newaetech/cw310-bergen-board/microfw/CW310/README.md

This folder contains the C firmware for the SAM3X on the CW310 board.

The Makefile for building is in the `Debug` folder.

The `atmel_devices_cdc.inf` driver shouldn't be required anymore
with the updated USB support.

See `README.md` instructions one folder down for build instructions.
