newaetech/cw310-bergen-board/docs/Images/CW310block.png

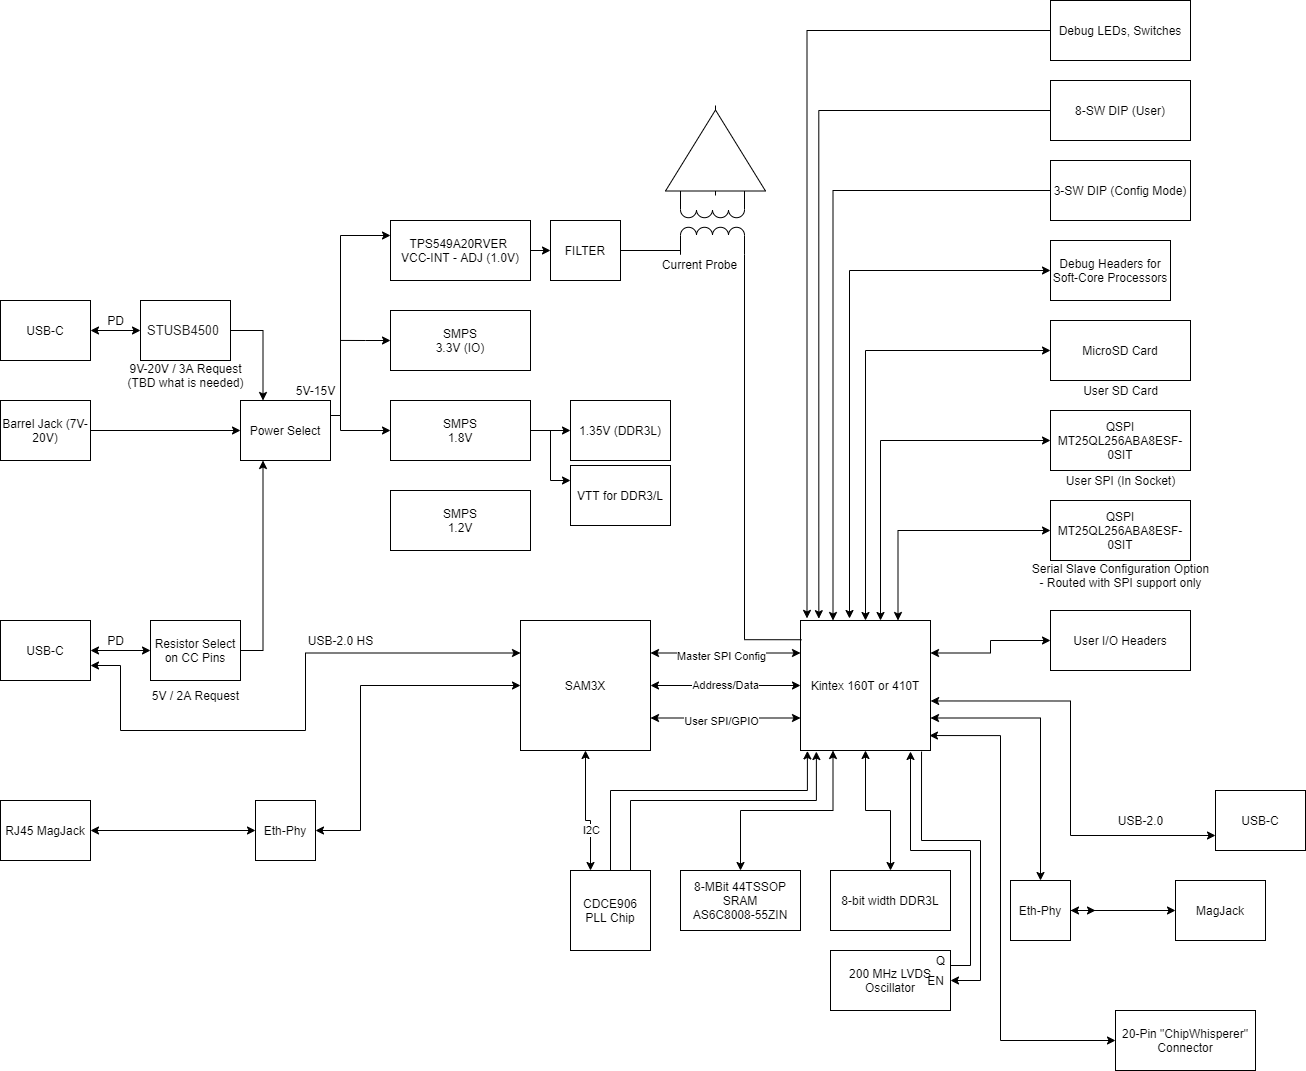
docs/Images/CW310block.png
