newaetech/cw310-bergen-board/docs/Images/switch_controlpower.jpeg

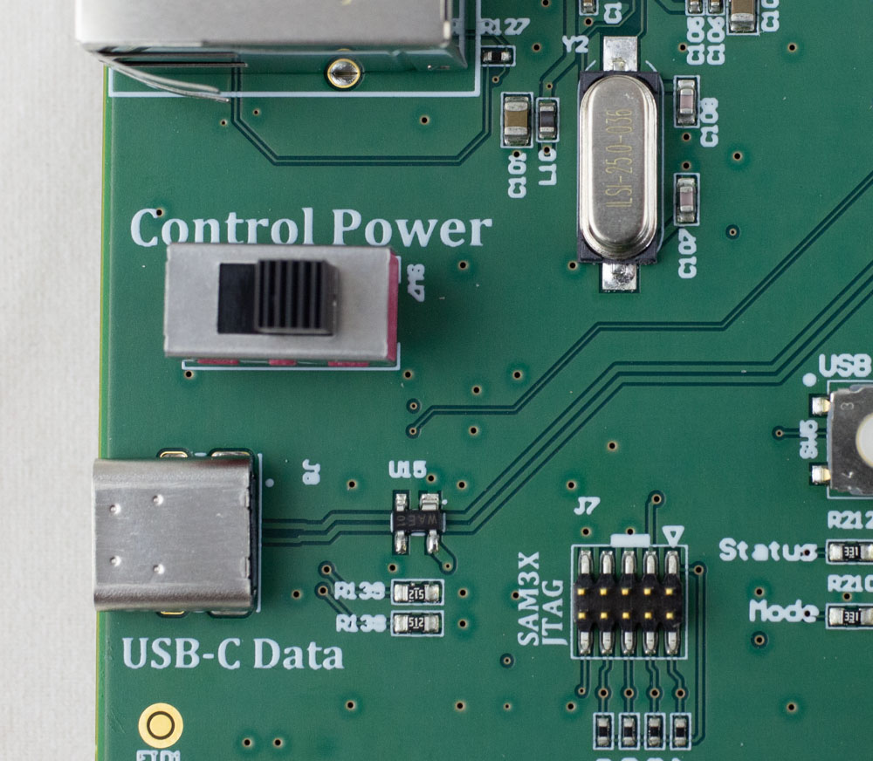
docs/Images/switch_controlpower.jpeg
