newaetech/cw310-bergen-board/docs/Images/cw310-userdebug.jpeg

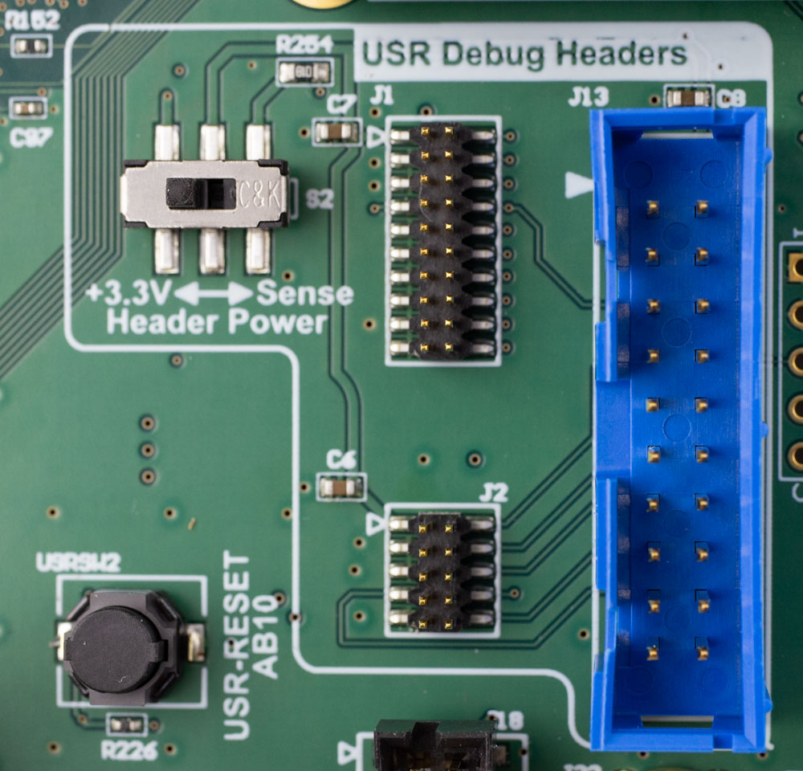
docs/Images/cw310-userdebug.jpeg
