newaetech/cw310-bergen-board/(threads)

Thread 3 (2021-06-08):

PLL / i2c hang-up

colinoflynn, 2021-06-08:
Issues report w/ the PLL set - not sure if just by chance or that is the real culprit. Based on their description (one write works, 2nd fails) I suspect the I2C code is locking up & blocks the USB processing from then on.

See https://github.com/lowRISC/opentitan/issues/6878

Should setup a stress test to slam PLL config messages. Is the PLL config message colliding with a random I2C read/write from temp?

colinoflynn, 2021-06-08:
Confirmed it happens with:

```
import chipwhisperer as cw
from chipwhisperer.capture.targets.CW310 import CW310

import time

def main():

    target = cw.target(None, CW310, bsfile=None, slurp=False)

    print("CW310 Board Found:")

    int i = 0
    while(True):
        print("Round %d"%i)
        target.pll.pll_enable_set(True)
        target.pll.pll_outenable_set(False, 0)
        # Note: 1 and 2 seem to be reversed.
        target.pll.pll_outenable_set(True, 1)
        target.pll.pll_outenable_set(False, 2)

        # Note: both 1 and 2 need to be set, even if only 1 is enabled.
        target.pll.pll_outfreq_set(100E6, 1)
        target.pll.pll_outfreq_set(100E6, 2)

        i += 1

        time.sleep(0.5)

    print("Loading done.")

if __name__ == "__main__":
    main()

```

colinoflynn, 2021-06-11:
Fixed by Alex - currently requires 'husky' branch of chipwhisperer, will close this one done in main develop branch.

Closed 2021-09-08.

Thread 4 (2021-06-08):

Update PCB to fix LNA Issues

colinoflynn, 2021-06-08:
Currently work-around on LNA required which is done with a PCB mod. Need to fix PCB:

* Improve grounding around LNA part.
* Change routing to remove longer path.

Thread 6 (2021-11-11):

Board files for vivado

nicolast0604, 2021-11-11:
If I would like to work on this board with Vivado, shall I install the board files?
If yes, where can I get it?

colinoflynn, 2021-11-11:
You can find two example applications at https://github.com/newaetech/cw310-bergen-board/tree/main/fpga - the "aes" examples is like the CW305 one, the "test" is a board test we use in production.

There is an XCF file at https://github.com/newaetech/cw310-bergen-board/tree/main/pins as well for your use.

If you want to run OpenTitan on the board you can follow the getting started guide one opentitan.org.

nicolast0604, 2021-11-11:
Hi Colinoflynn
I just followed the steps in opentitan and it is successful in implementation but failed in bitstream generation.
I opened the hardware manager and it seems connected but no target information showed.

As the experience of nexys video, I downloaded the board files from digilent and put it in the /data of the install path of Vivado.
I am wondering if I need to do the same thing to make the bitstream successfully?

Best Regards

nicolast0604, 2021-11-18:
Hi
My question is that I would like to let Vivado's hardware manager can recognize the CW310 board and let me program the device.
However, so far it shows no hardware target is open and only have localhost(0) status connected.

This is very confusing.

colinoflynn, 2021-11-18:
Got it! I misunderstood the problem there.

Do you have an external JTAG cable? The CW310 doesn't appear under Vivado, you need an external JTAG cable for this (Xilinx Platform USB cable or Xilinx SmartLynq cable). [Minor technical note - Xilinx doesn't provide a documented way of allowing us to do this is the main reason why, there is some special deal with Digilent allowing usage but it's never been clear on the license even if we reverse engineered it. As a result the FPGA jtag lines are just routed to a header on the board.]

nicolast0604, 2021-11-19:
Step 6 from the opentitan guideline,
Use a USB-C cable to connect your PC with the USB-C Data connector (J8) in the lower left corner on the board.

do you mean that we need to use Xilinx Platform USB cable or Xilinx SmartLynq cable to replace this?

Is this just make this FPGA board visable to Vivado or
it needs to even transfer the bit stream or firmware to the board?

Thread 7 (2023-06-26):

How to load firmware for SAM3X?

houdonghui1, 2023-06-26:
Hello engineers!!
How can I load the firmware on the CW310 board onto the SAM3X on my board? Under what operating system can software be used to load firmware onto the MCU? Is there a method explanation?

colinoflynn, 2023-06-26:
Hello,

The SAM3X firmware uses the same firmware loading as ChipWhisperer, so it works in Python (Windows or Linux). The FW update mechanism is described at https://chipwhisperer.readthedocs.io/en/latest/scope-api.html#firmware-update .

If the SAM3X is blank, use:

```
import chipwhisperer as cw
programmer = cw.SAMFWLoader(scope=None)
programmer.program(<port>, 'CW310.bin')
```
Where <port> is COMx, /dev/ttyUSB, etc depending on platform. You can also force erase the SAM3X with the 'erase' pins (jumper with wire/paperclip). But you can use the ChipWhisperer API to enter bootloader mode automatically too.

CW310 is built from running `make` here: https://github.com/newaetech/cw310-bergen-board/tree/main/microfw/CW310/src

ViennaPan, 2024-01-04:
Hi Colinoflynn,
When I trying to do SAM3X with:
programmer = cw.SAMFWLoader(scope=target)
programmer.enter_bootloader(really_enter=True)

I see all the power are down in CW310 board, and cannot get the target for ever.
Do you know why this occurring?
Before this erasing, I can use the USB-C Data to get the target and do fpga_read and fpga_write already. Now all are not working as all power off.
Thanks,
Vienna

colinoflynn, 2024-01-04:
Hello,

This will just erase the SAM3X, does it come back up as a serial port? Are you on Windows or Linux? If on Linux you can check `dmesg` to see if the SAM3X comes up as a serial port. If you press the "USB RST" button, it will reenumeate the SAM3X which might make it more obvious (or unplug/replug USB cable):

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

The command from there is:

```
import chipwhisperer as cw
programmer = cw.SAMFWLoader(scope=None)
programmer.program(<port>, 'CW310.bin')
```

Where CW310.bin is available [here](https://github.com/newaetech/cw310-bergen-board/blob/main/microfw/CW310/src/CW310.bin). Just download to your local file.

If the serial port isn't coming up, it could be the erase failed. There is an "erase" jumper (pins) on the PCB, you can short with a paperclip/wire which should also force the erase.

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

ViennaPan, 2024-01-05:
Hi colinoflynn,
Your method works. As the target cannot be get, I have to use the scope=None instead of scope=target in cw.SAMFWLoader. And the program is working.
Thanks,
Vienna

ViennaPan, 2024-01-08:
Hi colinoflynn,
The bin file "CW310 is built from running make here: https://github.com/newaetech/cw310-bergen-board/tree/main/microfw/CW310/src" has a problem that the byte counter of the bit 0 and bit 1 are by default as 1,  which is not working for plaintext and key write (any other 16 bytes write will be failed:
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
I added a workaround to not use the lowest 2 bits and find out that it is not supporting bit index 5 and index 6.
Could you help to check why?
Thanks,
Vienna

Thread 9 (2024-03-25):

CDCE906 Read Error

alex-dewar, 2024-03-25:
Latest firmware (1.3.0) seems to have broken I2C:

```python
>>> target = cw.target(None, cw.targets.CW310)
Traceback (most recent call last):
  File "<stdin>", line 1, in <module>
  File "/home/jw/projects/chipwhisperer/software/chipwhisperer/__init__.py", line 422, in target
    rtn.con(scope, **kwargs)
  File "/home/jw/projects/chipwhisperer/software/chipwhisperer/capture/targets/_base.py", line 65, in con
    self._con(scope, **kwargs)
  File "/home/jw/projects/chipwhisperer/software/chipwhisperer/capture/targets/CW310.py", line 143, in _con
    self.pll.cdce906init()
  File "/home/jw/projects/chipwhisperer/software/chipwhisperer/hardware/naeusb/pll_cdce906.py", line 265, in cdce906init
    self.outputUpdateOutputs(0)
  File "/home/jw/projects/chipwhisperer/software/chipwhisperer/hardware/naeusb/pll_cdce906.py", line 94, in outputUpdateOutputs
    pll_enabled = self.pll_outenable_get(outnum)
  File "/home/jw/projects/chipwhisperer/software/chipwhisperer/hardware/naeusb/pll_cdce906.py", line 140, in pll_outenable_get
    data = self.cdce906read(19 + outpin)
  File "/home/jw/projects/chipwhisperer/software/chipwhisperer/hardware/naeusb/pll_cdce906.py", line 255, in cdce906read
    raise IOError("CDCE906 Read Error, response = %d" % resp[0])
OSError: CDCE906 Read Error, response = 3
```

This works on earlier versions (1.2.0). Presumably something was changed when adding CW340 support that broke I2C.

alex-dewar, 2024-03-26:
Hopefully fixed by 76231fd01b90df4d3991aaca317a41fce6d278d3

Closed 2024-04-15.

Thread 10 (2024-10-16):

PLL numbers swapped for Bergen Board

KyleM32767, 2024-10-16:
On the CW310 Bergen Board, the numbers of the PLL outputs when calling `target.pll` methods do not correspond to the correct PLL output numbers. (i.e. calling `target.pll.pll_outenable_set(True, 2)` enables PLL output 1, and vice versa).

Looking at the schematic and constraint file, it seems like this is because the signals for PLL_CLK1 and PLL_CLK2 are on pins Y4 and Y1, respectively of the external PLL.

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

```
#####
# Input Clocks
#####

set_property -dict { PACKAGE_PIN  R22  IOSTANDARD   LVCMOS33 } [get_ports { PLL_CLK1 }]; #IO_L14P_T2_SRCC_13
set_property -dict { PACKAGE_PIN  N21  IOSTANDARD   LVCMOS33 } [get_ports { PLL_CLK2 }]; #IO_L12P_T1_MRCC_13
```

However [the API](https://github.com/newaetech/chipwhisperer/blob/develop/software/chipwhisperer/hardware/naeusb/pll_cdce906.py) assumes PLL_CLK1 is on pin Y1 and PLL_CLK2 is on Y4...

```py
    def outputUpdateOutputs(self, outnum, pllsrc_new=None, pllenabled_new=None, pllslewrate_new=None):
        """Update the output pins with enabled/disabled, slew rate, etc"""
        outnum = self.swap_340_pllnum(outnum)
        # Map to output pins on CDCE906 Chip
        if outnum == 0:
            outpin = 0
            if pllsrc_new is None:
                src = self._pll0source
            else:
                src = pllsrc_new

            if src == 'PLL0':
                divsrc = 0
            elif src == 'PLL1':
                divsrc = 1
            elif src == 'PLL2':
                divsrc = 2
        elif outnum == 1:
            outpin = 1
            divsrc = 1
        elif outnum == 2:
            outpin = 4
            divsrc = 2
```

The CW305 is that way, which tells me this is just a mistake with the CW310 design.

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

**TLDR: Switch the labels for PLL_CLK1 and PLL_CLK2 on the schematic and `bergen.xdc`**
