newaetech/cw310-bergen-board/fpga/aes/cw310.xdc

# default unless otherwise specified:
set_property IOSTANDARD LVCMOS33 [get_ports *]

set_property -dict { PACKAGE_PIN C16   IOSTANDARD LVCMOS33 } [get_ports { vauxp0 }]
set_property -dict { PACKAGE_PIN B16   IOSTANDARD LVCMOS33 } [get_ports { vauxn0 }]
set_property -dict { PACKAGE_PIN B17   IOSTANDARD LVCMOS33 } [get_ports { vauxp1 }]
set_property -dict { PACKAGE_PIN A19   IOSTANDARD LVCMOS33 } [get_ports { vauxn1 }]
set_property -dict { PACKAGE_PIN A18   IOSTANDARD LVCMOS33 } [get_ports { vauxp8 }]
set_property -dict { PACKAGE_PIN B16   IOSTANDARD LVCMOS33 } [get_ports { vauxn8 }]

set_property -dict { PACKAGE_PIN Y23   IOSTANDARD LVCMOS33 } [get_ports { usb_clk }]
set_property -dict { PACKAGE_PIN A23   IOSTANDARD LVCMOS33 } [get_ports { usb_trigger }]

#set_property -dict { PACKAGE_PIN  Y25  IOSTANDARD   LVCMOS33 } [get_ports { USB_nALE }]; #IO_L10P_T1_12
set_property -dict { PACKAGE_PIN AA23  IOSTANDARD   LVCMOS33 } [get_ports { USB_nCE }]; #IO_L11P_T1_SRCC_12
set_property -dict { PACKAGE_PIN AC23  IOSTANDARD   LVCMOS33 } [get_ports { USB_nRD }]; #IO_L14P_T2_SRCC_12
set_property -dict { PACKAGE_PIN AA25  IOSTANDARD   LVCMOS33 } [get_ports { USB_nWR }]; #IO_L7P_T1_12
set_property -dict { PACKAGE_PIN AC26  IOSTANDARD   LVCMOS33 } [get_ports { USB_A[0]  }]; #IO_L9N_T1_DQS_12
set_property -dict { PACKAGE_PIN AD26  IOSTANDARD   LVCMOS33 } [get_ports { USB_A[1]  }]; #IO_L21P_T3_DQS_12
set_property -dict { PACKAGE_PIN AD25  IOSTANDARD   LVCMOS33 } [get_ports { USB_A[2]  }]; #IO_L23P_T3_12
set_property -dict { PACKAGE_PIN AE26  IOSTANDARD   LVCMOS33 } [get_ports { USB_A[3]  }]; #IO_L21N_T3_DQS_12
set_property -dict { PACKAGE_PIN AB24  IOSTANDARD   LVCMOS33 } [get_ports { USB_A[4]  }]; #IO_L11N_T1_SRCC_12
set_property -dict { PACKAGE_PIN AC24  IOSTANDARD   LVCMOS33 } [get_ports { USB_A[5]  }]; #IO_L14N_T2_SRCC_12
set_property -dict { PACKAGE_PIN AD24  IOSTANDARD   LVCMOS33 } [get_ports { USB_A[6]  }]; #IO_L16N_T2_12
set_property -dict { PACKAGE_PIN AD23  IOSTANDARD   LVCMOS33 } [get_ports { USB_A[7]  }]; #IO_L16P_T2_12
set_property -dict { PACKAGE_PIN AB26  IOSTANDARD   LVCMOS33 } [get_ports { USB_A[8]  }]; #IO_L9P_T1_DQS_12
set_property -dict { PACKAGE_PIN AB25  IOSTANDARD   LVCMOS33 } [get_ports { USB_A[9]  }]; #IO_L7N_T1_12
set_property -dict { PACKAGE_PIN  W23  IOSTANDARD   LVCMOS33 } [get_ports { USB_A[10] }]; #IO_L8P_T1_12
set_property -dict { PACKAGE_PIN  V23  IOSTANDARD   LVCMOS33 } [get_ports { USB_A[11] }]; #IO_L3P_T0_DQS_12
set_property -dict { PACKAGE_PIN  Y21  IOSTANDARD   LVCMOS33 } [get_ports { USB_A[12] }]; #IO_L15N_T2_DQS_12
set_property -dict { PACKAGE_PIN  U24  IOSTANDARD   LVCMOS33 } [get_ports { USB_A[13] }]; #IO_L2P_T0_12
set_property -dict { PACKAGE_PIN  U22  IOSTANDARD   LVCMOS33 } [get_ports { USB_A[14] }]; #IO_L1P_T0_12
set_property -dict { PACKAGE_PIN  V22  IOSTANDARD   LVCMOS33 } [get_ports { USB_A[15] }]; #IO_L1N_T0_12
set_property -dict { PACKAGE_PIN  U21  IOSTANDARD   LVCMOS33 } [get_ports { USB_A[16] }]; #IO_0_12
set_property -dict { PACKAGE_PIN  V21  IOSTANDARD   LVCMOS33 } [get_ports { USB_A[17] }]; #IO_L6P_T0_12
set_property -dict { PACKAGE_PIN  W21  IOSTANDARD   LVCMOS33 } [get_ports { USB_A[18] }]; #IO_L6N_T0_VREF_12
set_property -dict { PACKAGE_PIN  W20  IOSTANDARD   LVCMOS33 } [get_ports { USB_A[19] }]; #IO_L15P_T2_DQS_12
set_property -dict { PACKAGE_PIN  U25  IOSTANDARD   LVCMOS33 } [get_ports { USB_D[0] }]; #IO_L2N_T0_12
set_property -dict { PACKAGE_PIN  U26  IOSTANDARD   LVCMOS33 } [get_ports { USB_D[1] }]; #IO_L4P_T0_12
set_property -dict { PACKAGE_PIN AC21  IOSTANDARD   LVCMOS33 } [get_ports { USB_D[2] }]; #IO_L18N_T2_12
set_property -dict { PACKAGE_PIN  V24  IOSTANDARD   LVCMOS33 } [get_ports { USB_D[3] }]; #IO_L3N_T0_DQS_12
set_property -dict { PACKAGE_PIN  V26  IOSTANDARD   LVCMOS33 } [get_ports { USB_D[4] }]; #IO_L4N_T0_12
set_property -dict { PACKAGE_PIN  W26  IOSTANDARD   LVCMOS33 } [get_ports { USB_D[5] }]; #IO_L5N_T0_12
set_property -dict { PACKAGE_PIN  W25  IOSTANDARD   LVCMOS33 } [get_ports { USB_D[6] }]; #IO_L5P_T0_12
set_property -dict { PACKAGE_PIN  Y26  IOSTANDARD   LVCMOS33 } [get_ports { USB_D[7] }]; #IO_L10N_T1_12


set_property -dict { PACKAGE_PIN  M26  IOSTANDARD   LVCMOS33 } [get_ports { USRLED0 }]; #IO_L5N_T0_13
set_property -dict { PACKAGE_PIN  M25  IOSTANDARD   LVCMOS33 } [get_ports { USRLED1 }]; #IO_L3P_T0_DQS_13
set_property -dict { PACKAGE_PIN  M24  IOSTANDARD   LVCMOS33 } [get_ports { USRLED2 }]; #IO_L8P_T1_13
#set_property -dict { PACKAGE_PIN  M19  IOSTANDARD   LVCMOS33 } [get_ports { USRLED3 }]; #IO_L22N_T3_13
#set_property -dict { PACKAGE_PIN  L25  IOSTANDARD   LVCMOS33 } [get_ports { USRLED4 }]; #IO_L3N_T0_DQS_13
#set_property -dict { PACKAGE_PIN  K26  IOSTANDARD   LVCMOS33 } [get_ports { USRLED5 }]; #IO_L1N_T0_13
#set_property -dict { PACKAGE_PIN  L24  IOSTANDARD   LVCMOS33 } [get_ports { USRLED6 }]; #IO_L8N_T1_13
#set_property -dict { PACKAGE_PIN  K25  IOSTANDARD   LVCMOS33 } [get_ports { USRLED7 }]; #IO_L1P_T0_13


set_property -dict { PACKAGE_PIN   U9  IOSTANDARD   LVCMOS18 } [get_ports { USRDIP0 }]; #IO_0_VRN_33
set_property -dict { PACKAGE_PIN   V7  IOSTANDARD   LVCMOS18 } [get_ports { USRDIP1 }]; #IO_L2N_T0_33
#set_property -dict { PACKAGE_PIN   V8  IOSTANDARD   LVCMOS18 } [get_ports { USRDIP2 }]; #IO_L2P_T0_33
#set_property -dict { PACKAGE_PIN   W9  IOSTANDARD   LVCMOS18 } [get_ports { USRDIP3 }]; #IO_L3N_T0_DQS_33
#set_property -dict { PACKAGE_PIN   V9  IOSTANDARD   LVCMOS18 } [get_ports { USRDIP4 }]; #IO_L6P_T0_33
#set_property -dict { PACKAGE_PIN   W8  IOSTANDARD   LVCMOS18 } [get_ports { USRDIP5 }]; #IO_L6N_T0_VREF_33
#set_property -dict { PACKAGE_PIN  W10  IOSTANDARD   LVCMOS18 } [get_ports { USRDIP6 }]; #IO_L3P_T0_DQS_33
#set_property -dict { PACKAGE_PIN  V11  IOSTANDARD   LVCMOS18 } [get_ports { USRDIP7 }]; #IO_L1P_T0_33


#set_property -dict { PACKAGE_PIN  Y11  IOSTANDARD   LVCMOS18 } [get_ports { USRSW0 }]; #IO_L5P_T0_33
#set_property -dict { PACKAGE_PIN  Y10  IOSTANDARD   LVCMOS18 } [get_ports { USRSW1 }]; #IO_L5N_T0_33
set_property -dict { PACKAGE_PIN   Y7  IOSTANDARD   LVCMOS18 } [get_ports { USRSW2 }]; #IO_L4N_T0_33


set_property -dict { PACKAGE_PIN AB21  IOSTANDARD   LVCMOS33 } [get_ports { CWIO_HS1 }]; #IO_L18P_T2_12
set_property -dict { PACKAGE_PIN  Y22  IOSTANDARD   LVCMOS33 } [get_ports { CWIO_HS2 }]; #IO_L13P_T2_MRCC_12
#set_property -dict { PACKAGE_PIN AE25  IOSTANDARD   LVCMOS33 } [get_ports { CWIO_IO1 }]; #IO_L23N_T3_12
#set_property -dict { PACKAGE_PIN AF25  IOSTANDARD   LVCMOS33 } [get_ports { CWIO_IO2 }]; #IO_L20N_T3_12
#set_property -dict { PACKAGE_PIN AF23  IOSTANDARD   LVCMOS33 } [get_ports { CWIO_IO3 }]; #IO_L22N_T3_12
set_property -dict { PACKAGE_PIN AF24  IOSTANDARD   LVCMOS33 } [get_ports { CWIO_IO4 }]; #IO_L20P_T3_12
#set_property -dict { PACKAGE_PIN AE21  IOSTANDARD   LVCMOS33 } [get_ports { CWIO_MISO }]; #IO_L19N_T3_VREF_12
#set_property -dict { PACKAGE_PIN AF22  IOSTANDARD   LVCMOS33 } [get_ports { CWIO_MOSI }]; #IO_L24N_T3_12
#set_property -dict { PACKAGE_PIN  Y20  IOSTANDARD   LVCMOS33 } [get_ports { CWIO_RST }]; #IO_25_12
#set_property -dict { PACKAGE_PIN AD21  IOSTANDARD   LVCMOS33 } [get_ports { CWIO_TPDIC }]; #IO_L19P_T3_12
#set_property -dict { PACKAGE_PIN AE23  IOSTANDARD   LVCMOS33 } [get_ports { CWIO_TPDID }]; #IO_L22P_T3_12
#set_property -dict { PACKAGE_PIN AE22  IOSTANDARD   LVCMOS33 } [get_ports { CWIO_TSCK }]; #IO_L24P_T3_12


set_property -dict { PACKAGE_PIN  R22  IOSTANDARD   LVCMOS33 } [get_ports { PLL_CLK1 }]; #IO_L14P_T2_SRCC_13
#set_property -dict { PACKAGE_PIN  N21  IOSTANDARD   LVCMOS33 } [get_ports { PLL_CLK2 }]; #IO_L12P_T1_MRCC_13


# clocks:
create_clock -period 10.000 -name usb_clk -waveform {0.000 5.000} [get_nets usb_clk]
create_clock -period 10.000 -name CWIO_HS2 -waveform {0.000 5.000} [get_nets CWIO_HS2]
create_clock -period 10.000 -name PLL_CLK1 -waveform {0.000 5.000} [get_nets PLL_CLK1]

# both input clocks have same properties so there is no point in doing timing analysis for both:
set_case_analysis 1 [get_pins U_clocks/CCLK_MUX/S]

# No spec for these, seems sensible:
set_input_delay -clock usb_clk -add_delay 2.000 [get_ports USB_A]
set_input_delay -clock usb_clk -add_delay 2.000 [get_ports USB_D]
set_input_delay -clock usb_clk -add_delay 2.000 [get_ports usb_trigger]
set_input_delay -clock usb_clk -add_delay 2.000 [get_ports USB_nCE]
set_input_delay -clock usb_clk -add_delay 2.000 [get_ports USB_nRD]
set_input_delay -clock usb_clk -add_delay 2.000 [get_ports USB_nWR]

set_input_delay -clock usb_clk -add_delay 0.000 [get_ports USRDIP0]
set_input_delay -clock usb_clk -add_delay 0.000 [get_ports USRDIP1]
set_input_delay -clock [get_clocks usb_clk] -add_delay 0.500 [get_ports USRSW2]

set_output_delay -clock usb_clk 0.000 [get_ports USRLED0]
set_output_delay -clock usb_clk 0.000 [get_ports USRLED1]
set_output_delay -clock usb_clk 0.000 [get_ports USRLED2]
set_output_delay -clock usb_clk 0.000 [get_ports USB_D]
set_output_delay -clock usb_clk 0.000 [get_ports CWIO_IO4]
set_output_delay -clock usb_clk 0.000 [get_ports CWIO_HS1]
set_false_path -to [get_ports USRLED0]
set_false_path -to [get_ports USRLED1]
set_false_path -to [get_ports USRLED2]
set_false_path -to [get_ports USB_D]
set_false_path -to [get_ports CWIO_IO4]
set_false_path -to [get_ports CWIO_HS1]

set_property CFGBVS VCCO [current_design]
set_property CONFIG_VOLTAGE 3.3 [current_design]

set_property BITSTREAM.CONFIG.USR_ACCESS TIMESTAMP [current_design]
set_property C_CLK_INPUT_FREQ_HZ 300000000 [get_debug_cores dbg_hub]
set_property C_ENABLE_CLK_DIVIDER false [get_debug_cores dbg_hub]
set_property C_USER_SCAN_CHAIN 1 [get_debug_cores dbg_hub]
connect_debug_port dbg_hub/clk [get_nets usb_clk_buf]
