newaetech/cw310-bergen-board/microfw/CW310/src/config/conf_clock.h

/**
 * \file
 *
 * \brief SAM3U clock configuration.
 *
 * Copyright (c) 2011 - 2014 Atmel Corporation. All rights reserved.
 *
 * \asf_license_start
 *
 * \page License
 *
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
 * 3. The name of Atmel may not be used to endorse or promote products derived
 *    from this software without specific prior written permission.
 *
 * 4. This software may only be redistributed and used in connection with an
 *    Atmel microcontroller product.
 *
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
 * \asf_license_stop
 *
 */

#ifndef CONF_CLOCK_H_INCLUDED
#define CONF_CLOCK_H_INCLUDED

// ===== System Clock (MCK) Source Options
//#define CONFIG_SYSCLK_SOURCE        SYSCLK_SRC_SLCK_RC
//#define CONFIG_SYSCLK_SOURCE        SYSCLK_SRC_SLCK_XTAL
//#define CONFIG_SYSCLK_SOURCE        SYSCLK_SRC_SLCK_BYPASS
//#define CONFIG_SYSCLK_SOURCE        SYSCLK_SRC_MAINCK_4M_RC
//#define CONFIG_SYSCLK_SOURCE        SYSCLK_SRC_MAINCK_8M_RC
//#define CONFIG_SYSCLK_SOURCE        SYSCLK_SRC_MAINCK_12M_RC
//#define CONFIG_SYSCLK_SOURCE        SYSCLK_SRC_MAINCK_XTAL
//#define CONFIG_SYSCLK_SOURCE        SYSCLK_SRC_MAINCK_BYPASS
#define CONFIG_SYSCLK_SOURCE        SYSCLK_SRC_PLLACK
//#define CONFIG_SYSCLK_SOURCE        SYSCLK_SRC_UPLLCK

// ===== System Clock (MCK) Prescaler Options   (Fmck = Fsys / (SYSCLK_PRES))
//#define CONFIG_SYSCLK_PRES          SYSCLK_PRES_1
#define CONFIG_SYSCLK_PRES          SYSCLK_PRES_2
//#define CONFIG_SYSCLK_PRES          SYSCLK_PRES_4
//#define CONFIG_SYSCLK_PRES          SYSCLK_PRES_8
//#define CONFIG_SYSCLK_PRES          SYSCLK_PRES_16
//#define CONFIG_SYSCLK_PRES          SYSCLK_PRES_32
//#define CONFIG_SYSCLK_PRES          SYSCLK_PRES_64
//#define CONFIG_SYSCLK_PRES          SYSCLK_PRES_3

// ===== PLL0 (A) Options   (Fpll = (Fclk * PLL_mul) / PLL_div)
// Use mul and div effective values here.
#define CONFIG_PLL0_SOURCE          PLL_SRC_MAINCK_XTAL
#define CONFIG_PLL0_MUL             14
#define CONFIG_PLL0_DIV             1

#define CONFIG_USBCLK_SOURCE        CONFIG_PLL1_SOURCE
#define CONFIG_USBCLK_DIV           2

// ===== UPLL (UTMI) Hardware fixed at 480 MHZ.

// ===== USB Clock Source fixed at UPLL.

// ===== Target frequency (System clock)
// - XTAL frequency: 12MHZ
// - System clock source: PLLA
// - System clock prescaler: 2 (divided by 2)
// - PLLA source: XTAL
// - PLLA output: XTAL * 16 / 1
// - System clock is: 12 * 16 / 1 / 2 = 96MHZ
// ===== Target frequency (USB Clock)
// - USB clock source: UPLL
// - UPLL frequency: 480MHZ
// - USB clock: 480MHZ


#endif /* CONF_CLOCK_H_INCLUDED */
