newaetech/cw310-bergen-board/microfw/CW310/src/naeusb_luna.h

/*
 * naeusb_bergen.h
 *
 * Created: 7/12/2021 8:42:43 PM
 *  Author: adewa
 */ 


#ifndef NAEUSB_LUNA_H_
#define NAEUSB_LUNA_H_

#define REQ_FPGA_MODE_PINS 0x4A
#define REQ_LUNA_FPGA_SETTINGS 0x4B


void luna_register_handlers(void);


#endif /* NAEUSB_LUNA_H_ */
