newaetech/cw310-bergen-board/fpga/ddr_test/ddr_test.srcs/sources_1/ip/xadc_wiz_0/xadc_wiz_0_sim_netlist.v

// Copyright 1986-2020 Xilinx, Inc. All Rights Reserved.
// --------------------------------------------------------------------------------
// Tool Version: Vivado v.2020.2 (lin64) Build 3064766 Wed Nov 18 09:12:47 MST 2020
// Date        : Tue Jul 26 19:35:31 2022
// Host        : red running 64-bit Ubuntu 18.04.6 LTS
// Command     : write_verilog -force -mode funcsim
//               /home/jpnewae/git/bergen/cw310-bergen-board/fpga/ddr_test/ddr_test.srcs/sources_1/ip/xadc_wiz_0/xadc_wiz_0_sim_netlist.v
// Design      : xadc_wiz_0
// Purpose     : This verilog netlist is a functional simulation representation of the design and should not be modified
//               or synthesized. This netlist cannot be used for SDF annotated simulation.
// Device      : xc7k160tfbg676-2
// --------------------------------------------------------------------------------
`timescale 1 ps / 1 ps

(* NotValidForBitStream *)
module xadc_wiz_0
   (daddr_in,
    den_in,
    di_in,
    dwe_in,
    do_out,
    drdy_out,
    s_axis_aclk,
    m_axis_aclk,
    m_axis_resetn,
    m_axis_tdata,
    m_axis_tvalid,
    m_axis_tid,
    m_axis_tready,
    vauxp0,
    vauxn0,
    vauxp1,
    vauxn1,
    vauxp8,
    vauxn8,
    channel_out,
    busy_out,
    eoc_out,
    eos_out,
    ot_out,
    vccaux_alarm_out,
    vccint_alarm_out,
    user_temp_alarm_out,
    vbram_alarm_out,
    alarm_out,
    temp_out,
    vp_in,
    vn_in);
  input [6:0]daddr_in;
  input den_in;
  input [15:0]di_in;
  input dwe_in;
  output [15:0]do_out;
  output drdy_out;
  input s_axis_aclk;
  input m_axis_aclk;
  input m_axis_resetn;
  output [15:0]m_axis_tdata;
  output m_axis_tvalid;
  output [4:0]m_axis_tid;
  input m_axis_tready;
  input vauxp0;
  input vauxn0;
  input vauxp1;
  input vauxn1;
  input vauxp8;
  input vauxn8;
  output [4:0]channel_out;
  output busy_out;
  output eoc_out;
  output eos_out;
  output ot_out;
  output vccaux_alarm_out;
  output vccint_alarm_out;
  output user_temp_alarm_out;
  output vbram_alarm_out;
  output alarm_out;
  output [11:0]temp_out;
  input vp_in;
  input vn_in;

  wire alarm_out;
  wire busy_out;
  wire [4:0]channel_out;
  wire [6:0]daddr_in;
  wire den_in;
  wire [15:0]di_in;
  wire [15:0]do_out;
  wire drdy_out;
  wire dwe_in;
  wire eoc_out;
  wire eos_out;
  wire m_axis_aclk;
  wire m_axis_resetn;
  wire [15:0]m_axis_tdata;
  wire [4:0]m_axis_tid;
  wire m_axis_tready;
  wire m_axis_tvalid;
  wire ot_out;
  wire s_axis_aclk;
  wire [11:0]temp_out;
  wire user_temp_alarm_out;
  wire vauxn0;
  wire vauxn1;
  wire vauxn8;
  wire vauxp0;
  wire vauxp1;
  wire vauxp8;
  wire vbram_alarm_out;
  wire vccaux_alarm_out;
  wire vccint_alarm_out;
  wire vn_in;
  wire vp_in;
  wire [6:4]NLW_inst_alarm_out_UNCONNECTED;

  xadc_wiz_0_xadc_wiz_0_axi_xadc inst
       (.alarm_out({alarm_out,NLW_inst_alarm_out_UNCONNECTED[6:4],vbram_alarm_out,vccaux_alarm_out,vccint_alarm_out,user_temp_alarm_out}),
        .busy_out(busy_out),
        .channel_out(channel_out),
        .daddr_in(daddr_in),
        .den_in(den_in),
        .di_in(di_in),
        .do_out(do_out),
        .drdy_out(drdy_out),
        .dwe_in(dwe_in),
        .eoc_out(eoc_out),
        .eos_out(eos_out),
        .m_axis_aclk(m_axis_aclk),
        .m_axis_resetn(m_axis_resetn),
        .m_axis_tdata(m_axis_tdata),
        .m_axis_tid(m_axis_tid),
        .m_axis_tready(m_axis_tready),
        .m_axis_tvalid(m_axis_tvalid),
        .ot_out(ot_out),
        .s_axis_aclk(s_axis_aclk),
        .temp_out(temp_out),
        .vauxn0(vauxn0),
        .vauxn1(vauxn1),
        .vauxn8(vauxn8),
        .vauxp0(vauxp0),
        .vauxp1(vauxp1),
        .vauxp8(vauxp8),
        .vn_in(vn_in),
        .vp_in(vp_in));
endmodule

(* ORIG_REF_NAME = "drp_arbiter" *) 
module xadc_wiz_0_drp_arbiter
   (m_axis_reset,
    den_C,
    dwe_C,
    overlap_B_reg_0,
    drdy_i,
    drdy_out,
    wren_fifo,
    \do_A_reg_reg[14]_0 ,
    Q,
    \FSM_sequential_state_reg[0]_0 ,
    \do_A_reg_reg[15]_0 ,
    state__0,
    do_out,
    \daddr_C_reg_reg[6]_0 ,
    \di_C_reg_reg[15]_0 ,
    m_axis_aclk,
    den_reg,
    \m_axis_tdata[15] ,
    m_axis_resetn,
    \FSM_sequential_state_reg[3] ,
    mode_change,
    \FSM_sequential_state_reg[3]_0 ,
    \FSM_sequential_state_reg[3]_1 ,
    eoc_out,
    channel_out,
    di_in,
    daddr_in,
    \daddr_C_reg_reg[6]_1 ,
    dwe_in,
    drdy_C,
    bbusy_A,
    den_A,
    den_in,
    jtaglocked_i,
    DO,
    overlap_A,
    \FSM_sequential_state_reg[0]_1 );
  output m_axis_reset;
  output den_C;
  output dwe_C;
  output overlap_B_reg_0;
  output drdy_i;
  output drdy_out;
  output wren_fifo;
  output \do_A_reg_reg[14]_0 ;
  output [15:0]Q;
  output \FSM_sequential_state_reg[0]_0 ;
  output \do_A_reg_reg[15]_0 ;
  output [1:0]state__0;
  output [15:0]do_out;
  output [6:0]\daddr_C_reg_reg[6]_0 ;
  output [15:0]\di_C_reg_reg[15]_0 ;
  input m_axis_aclk;
  input den_reg;
  input \m_axis_tdata[15] ;
  input m_axis_resetn;
  input \FSM_sequential_state_reg[3] ;
  input mode_change;
  input [0:0]\FSM_sequential_state_reg[3]_0 ;
  input \FSM_sequential_state_reg[3]_1 ;
  input eoc_out;
  input [0:0]channel_out;
  input [15:0]di_in;
  input [6:0]daddr_in;
  input [5:0]\daddr_C_reg_reg[6]_1 ;
  input dwe_in;
  input drdy_C;
  input bbusy_A;
  input den_A;
  input den_in;
  input jtaglocked_i;
  input [15:0]DO;
  input overlap_A;
  input \FSM_sequential_state_reg[0]_1 ;
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
