newaetech/cw310-bergen-board/(commit log)

2021-03-30 Add rev06 schematic
2021-04-04 Add XDC file for bergen board
    [bergen_pins.csv]
2021-04-04 Main landing page readme
2021-04-04 Add links to schematic + XDC
2021-04-04 Add fan header part numbers
2021-04-06 Fix XDC - oscillator enable is 1.8V
    [bergen.xdc]
2021-04-07 XDC: fix things that Vivado doesn't like
    [bergen.xdc]
2021-04-14 Update heatsink PN
2021-04-14 Add FPGAIO read pin state
2021-04-15 Minor changes to fan logic - come on stronger now at first
2021-04-16 Add fpga power kill/enable, temp sensor comms to usb
2021-04-19 Board test bitfile with AES and SRAM.
2021-04-20 Fix SRAM test.
    Add 1 cycle, assert CEN on writes.
    [simple_sram_rwtest.v]
2021-04-20 Fix SRAM write timing again.
    [cw310_defines.v, cw310_reg_aes.v, cw310_top.v, simple_sram_rwtest.v, tb.v]
2021-04-22 Add missing MIG and ILA IP
    [ddr3_model.sv, example_top.v, ila_ddr3.v, ila_ddr3_stub.v, ila_ddr3_stub.vhdl, mig_7series_nosysclock.v]
2021-04-23 Readd usbc/i2c usb commands
2021-04-23 Update bin w/ FAN speed changes
2021-04-27 Update CW310 schematic
2021-05-25 Add fan fixes
2021-06-09 Add untested I2C lock
2021-06-11 Add I2C lock
2021-09-24 Working bergen board w/naeusb
2021-10-26 Fix FPGA XADC.
    Previously was returning 0 on all XADC reads because read data wasn't
    being registered at the right time.
    Also made the status error bits sticky (write to clear).
    [cw310.xdc, cw310_reg_aes.v, cw310_top.v, ddr3_model.sv, example_top.v, mig_7series_nosysclock.v]
2021-11-03 FPGA test bitfile: fix MIG instantiation
    WIP towards proper DDR testing.
    Also updated to Vivado 2020.2
    [cw310_reg_aes.v, cw310_top.v, example_top.v, ila_crypto.v, ila_crypto_stub.v]
2021-12-15 mpsse changes, not working yet
    [CW310_platform.h]
2022-07-28 Add DDR-only FPGA build with more instrumentation.
    To explore throughput and stalling characteristics, to plan storage
    architecture for Husky-Pro.
    [cw310.xdc, cw310_defines.v, cw310_reg_ddr.v, cw310_top.v, ddr3_model.sv, example_top.v, ila_simple_ddr3.v]
2023-01-16 move i2c setup to main
2023-02-03 prog not working yet
    [main_cw340.c, naeusb_board_config.h, naeusb_luna.c, naeusb_luna.h, usbc_pd.c]
2023-02-08 add new luna board c files
2023-02-09 working selectmap and DMA serial
2023-02-10 VFD display, openocd config, change FW version
    [luna_openocd.cfg]
2023-02-17 Working build, rework i2c, needs testing
    [conf_usb.h, main_cw310.c, naeusb_board_config.h, thermal_power.c, usbc_pd.c]
2023-07-04 WR FPGA on upper byte, fix? ALE pin
    [main_cw310.c, main_cw340.c, naeusb_luna.c]
2023-07-05 maybe fix cw340 parallel write
    [naeusb_luna.c]
2023-07-10 fix missing buflen set on fpga read
    [naeusb_luna.c]
2023-08-17 change ALE pin to PA28 (USB_SPI_CS)
2023-09-21 Bump CW340 version, more fixes
    [conf_usb.h, main_cw340.c]
2024-03-26 Hopefully fix I2C bug
    [main_cw310.c, naeusb_bergen.c, naeusb_board_config.h, usbc_pd.c]
2024-04-25 Fix lockup on usb_cdc and bump version
    [conf_usb.h]
2024-07-02 Fix CDC for CW340, bump version
    [conf_usb.h, main_cw340.c]
2025-12-16 Fix CW310 bulk write
    [conf_usb.h]
